AaronWu-train/color-mixer/(commit log)

2025-05-09 Initial commit
    - Add initial project structure and files
    - The structure is as follows:
    - .env.sample
    - README.md
    - pyproject.toml
    - Makefile: Makefile for simply building and running the project
    - docs/
    - placeholder for documentation files
    - core/
    - placeholder for core logic and algorithms of color mixing
    - hw_agent/
    - placeholder for hardware agent files
    - ui/
    - placeholder for web ui files, may use React or streamlit
    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
2025-05-14 Add API schemas for core and hw_agent modules
    - I add schemas for the core and hw_agent modules to define the
    json structures used in the application.
    - Please refer to the api documentation for details on the new schemas.
    - schemas.py files that defines the schemas for
    the APIs.
    - main.py files that handle the Sample API requests and responses.
    - added drivers files are blank, only for future use.
2025-05-22 Add TODO comment to status endpoint for reading current state
2025-05-23 preliminary: color sensor to mixbox RGB, unfinished
2025-05-24 refactor: remove unused GPIO import from main.py
    - I reject the idea of importing GPIO in main.py, as it is not used in the code.
    - Also, GPIO is only able to used on rpi, so i prefer it only be imported
    in the driver/ directory, where it is actually used.
    - Mention: @ShengYuCheng
2025-05-25 Finish hw_client for core to communicate with hardware agent
    - Added `hw_client.py` to handle communication with the hardware agent.
    - Updated `config.py` to include env variables and API URL.
    - Modified `main.py` to initialize the hardware client.
    - Created a sample `.env` file for environment variables.
2025-05-25 feat: add color sensor and pump driver implementations
2025-05-27 caluculate color correction matrix in calibration_TCS
2025-05-29 refactor: format arrays in calibration_TCS and improve readability; rename to utils.py for sensor data processing
2025-06-07 feat: implement calibration functions for RGB and color correction; remove obsolete calibration_TCS.py
    [colorsensor.py, pump.py]
2025-06-09 Finish calibration
2025-06-09 feat: implement color calibration; add calibration services and update color service
2025-06-09 feat: add optional dependencies for Raspberry Pi support
2025-06-10 feat: implement halt functionality for pumps and update dosing logic
2025-06-10 hotfix: resolve the blunder mistake of accessing `none` pin GPIO setup
    [pump.py]
2025-06-10 fix: correct task initialization and pump index usage
    - Predeclare `tasks = []` in `start_dose` to prevent UnboundLocalError in exception/finally blocks
    - Change dose item access from `item["id"]`/`item["volume"]` to `item.id`/`item.volume`
    - In `pump.py`, replace erroneous `pin` variable with the `index` parameter when accessing `pump_index`
    - Skip `None` entries in `haltPumpAll` to avoid invalid `GPIO.output` calls
    [pump.py]
2025-06-10 hotfix: fix the fxxing model resolving issue - The dose/ and stop/ endpoints are now finished
    [pump.py]
2025-06-10 refactor: remove debug print statements from start_dose function
2025-06-10 fix: adjust sensor gain and integration time for improved color readings
    [colorsensor.py]
2025-06-10 fix: update calibration references and improve clear channel removal logic
2025-06-10 fix: remove calibration step and apply gamma correction for color processing
2025-06-10 fix: adjust clear channel removal logic and restore calibration step in color processing
2025-06-10 Finally a good calibration
2025-06-11 fix: improve mixing logic and add new color calibration references
2025-06-11 Add purple in calibration.py
2025-06-12 hotfix: add under motor
2025-06-12 Fix motor
2025-06-12 Add matrix calibration
2025-06-17 fix: update calibration references
2025-06-17 fix: adjust batch volume and tolerance values for color mixing; update calibration color references
2025-06-17 fix: add waiting loop for pump status during color mixing process
2026-02-12 fix: update button text in ColorCard component for clarity
